adman234/-other/hardware/scorbot-controller/docs/pcb_placement.png

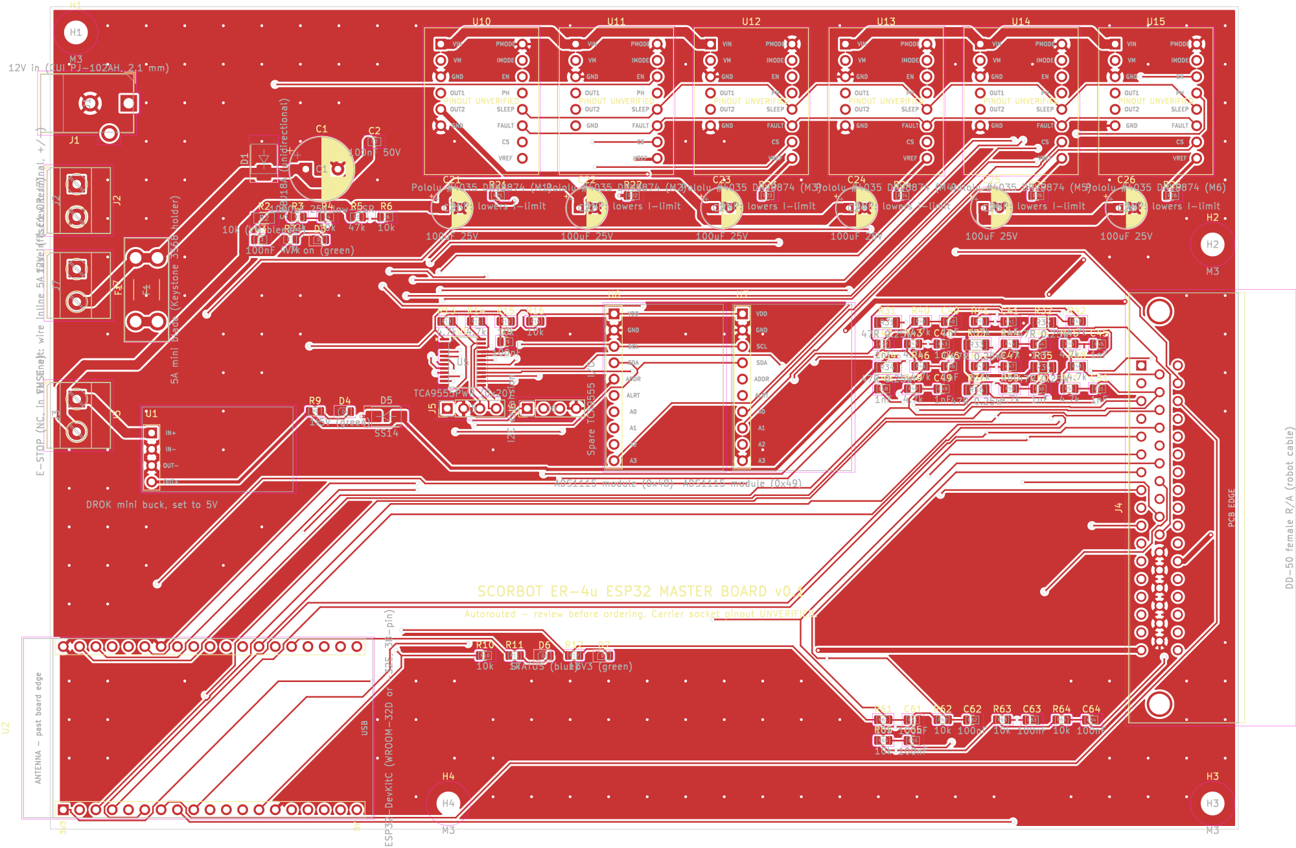
hardware/scorbot-controller/docs/pcb_placement.png
