adman234/-other/hardware/scorbot-controller/docs/schematic.pdf

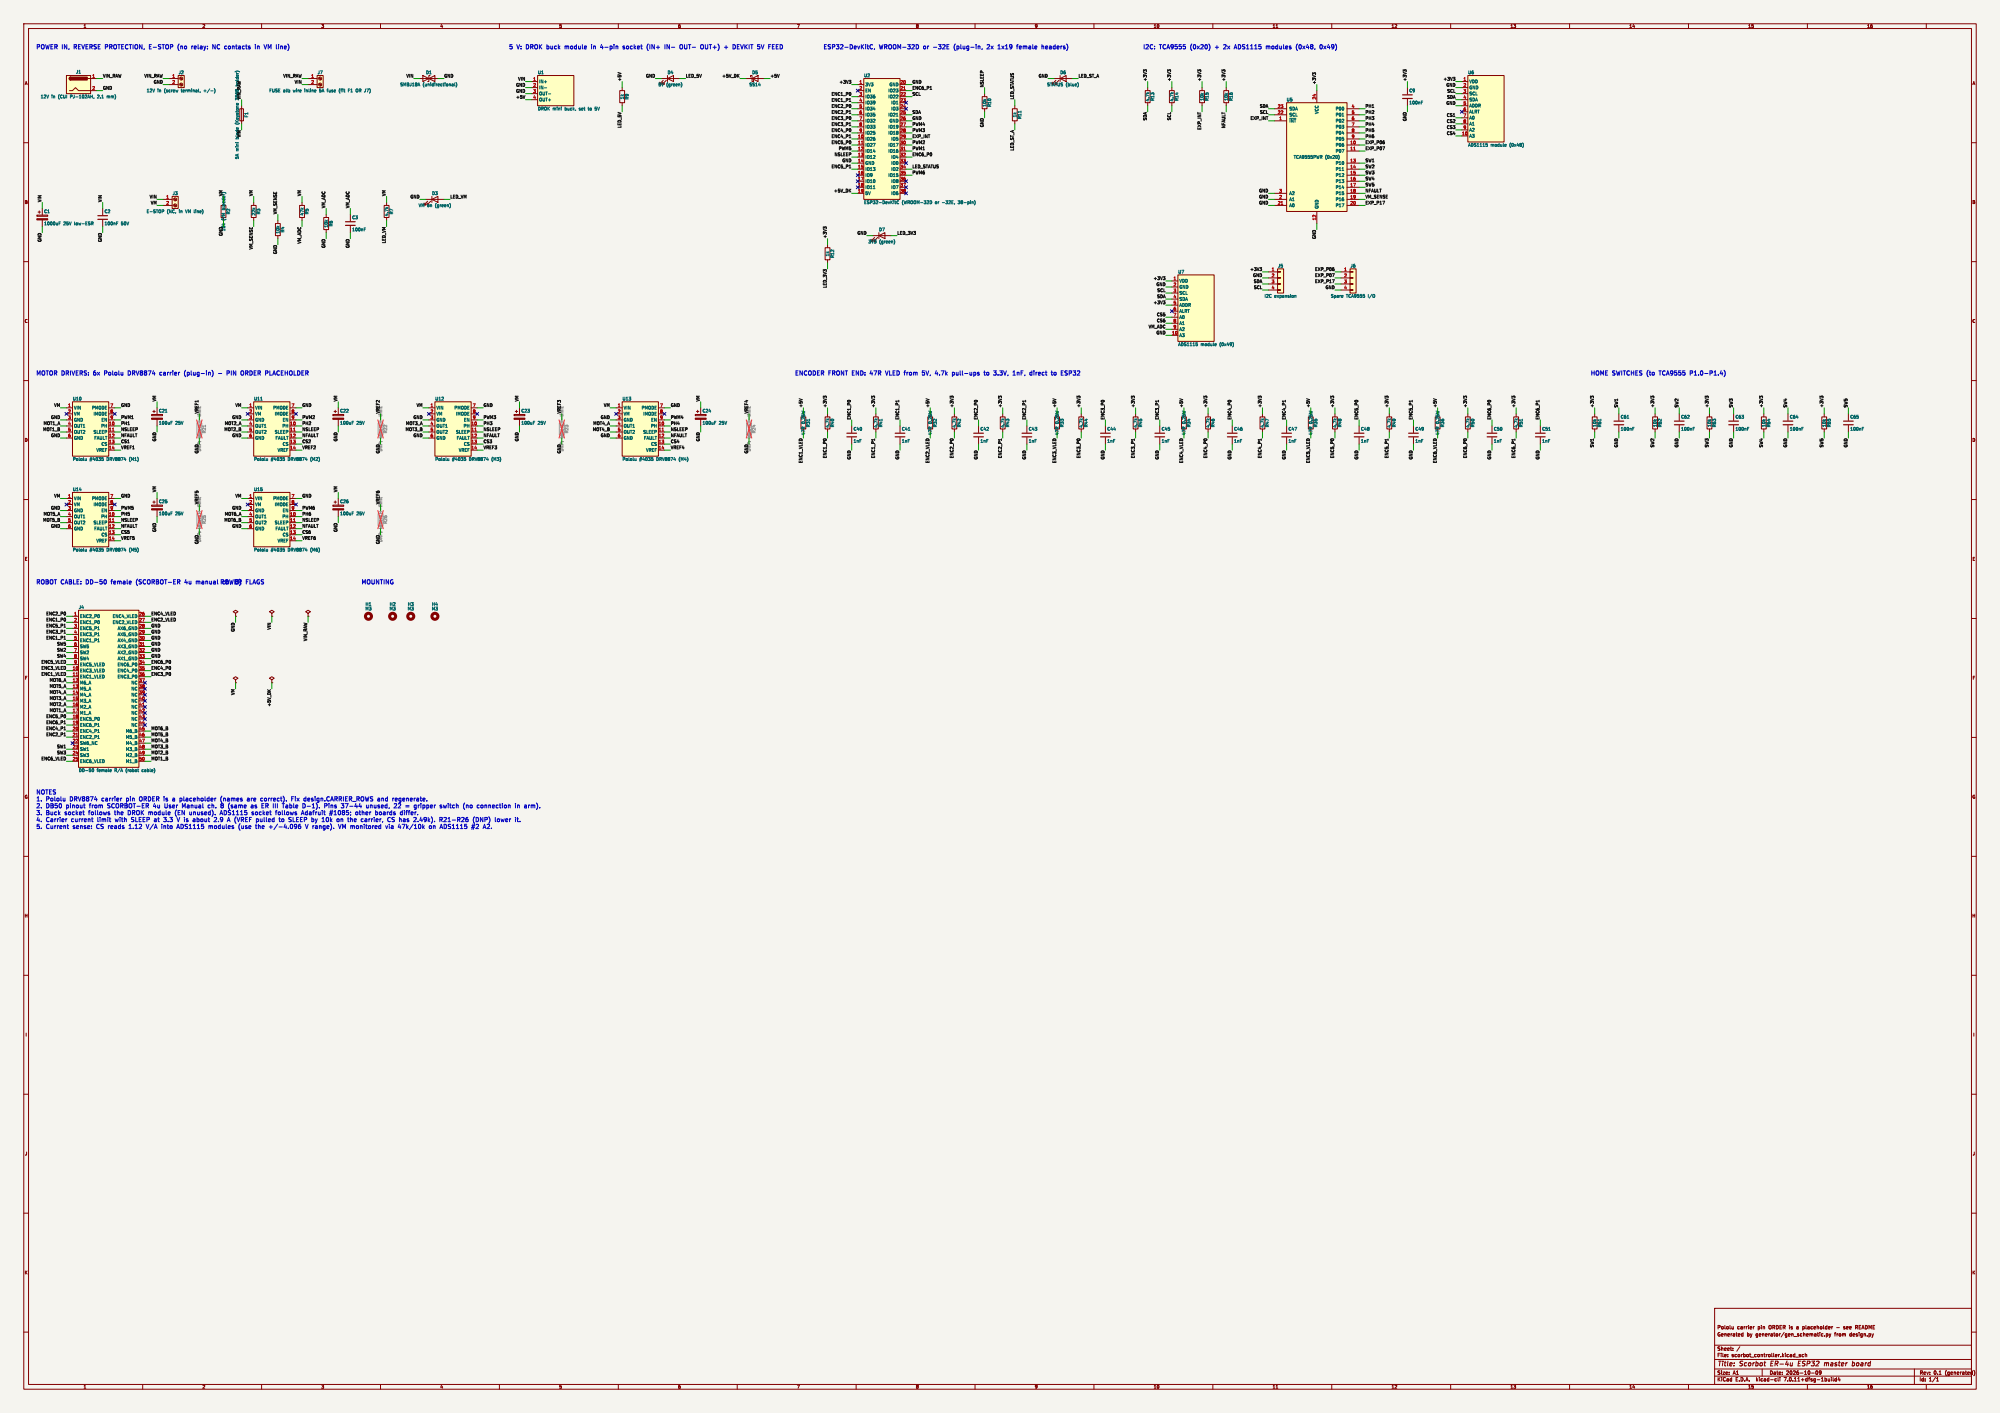
[picture p3: page 1]

J7 FUSE alt: wire inline 5A fuse (fit F1 OR J7) C2
VIN GND
GND

IN- 2 OUT- 3 OUT+ 4 U1 DROK mini buck, set to 5V
