adman234/-other/hardware/scorbot-controller/scorbot_controller.kicad_pcb

## KiCad design hardware/scorbot-controller/scorbot_controller.kicad_pcb (2026-10-11)

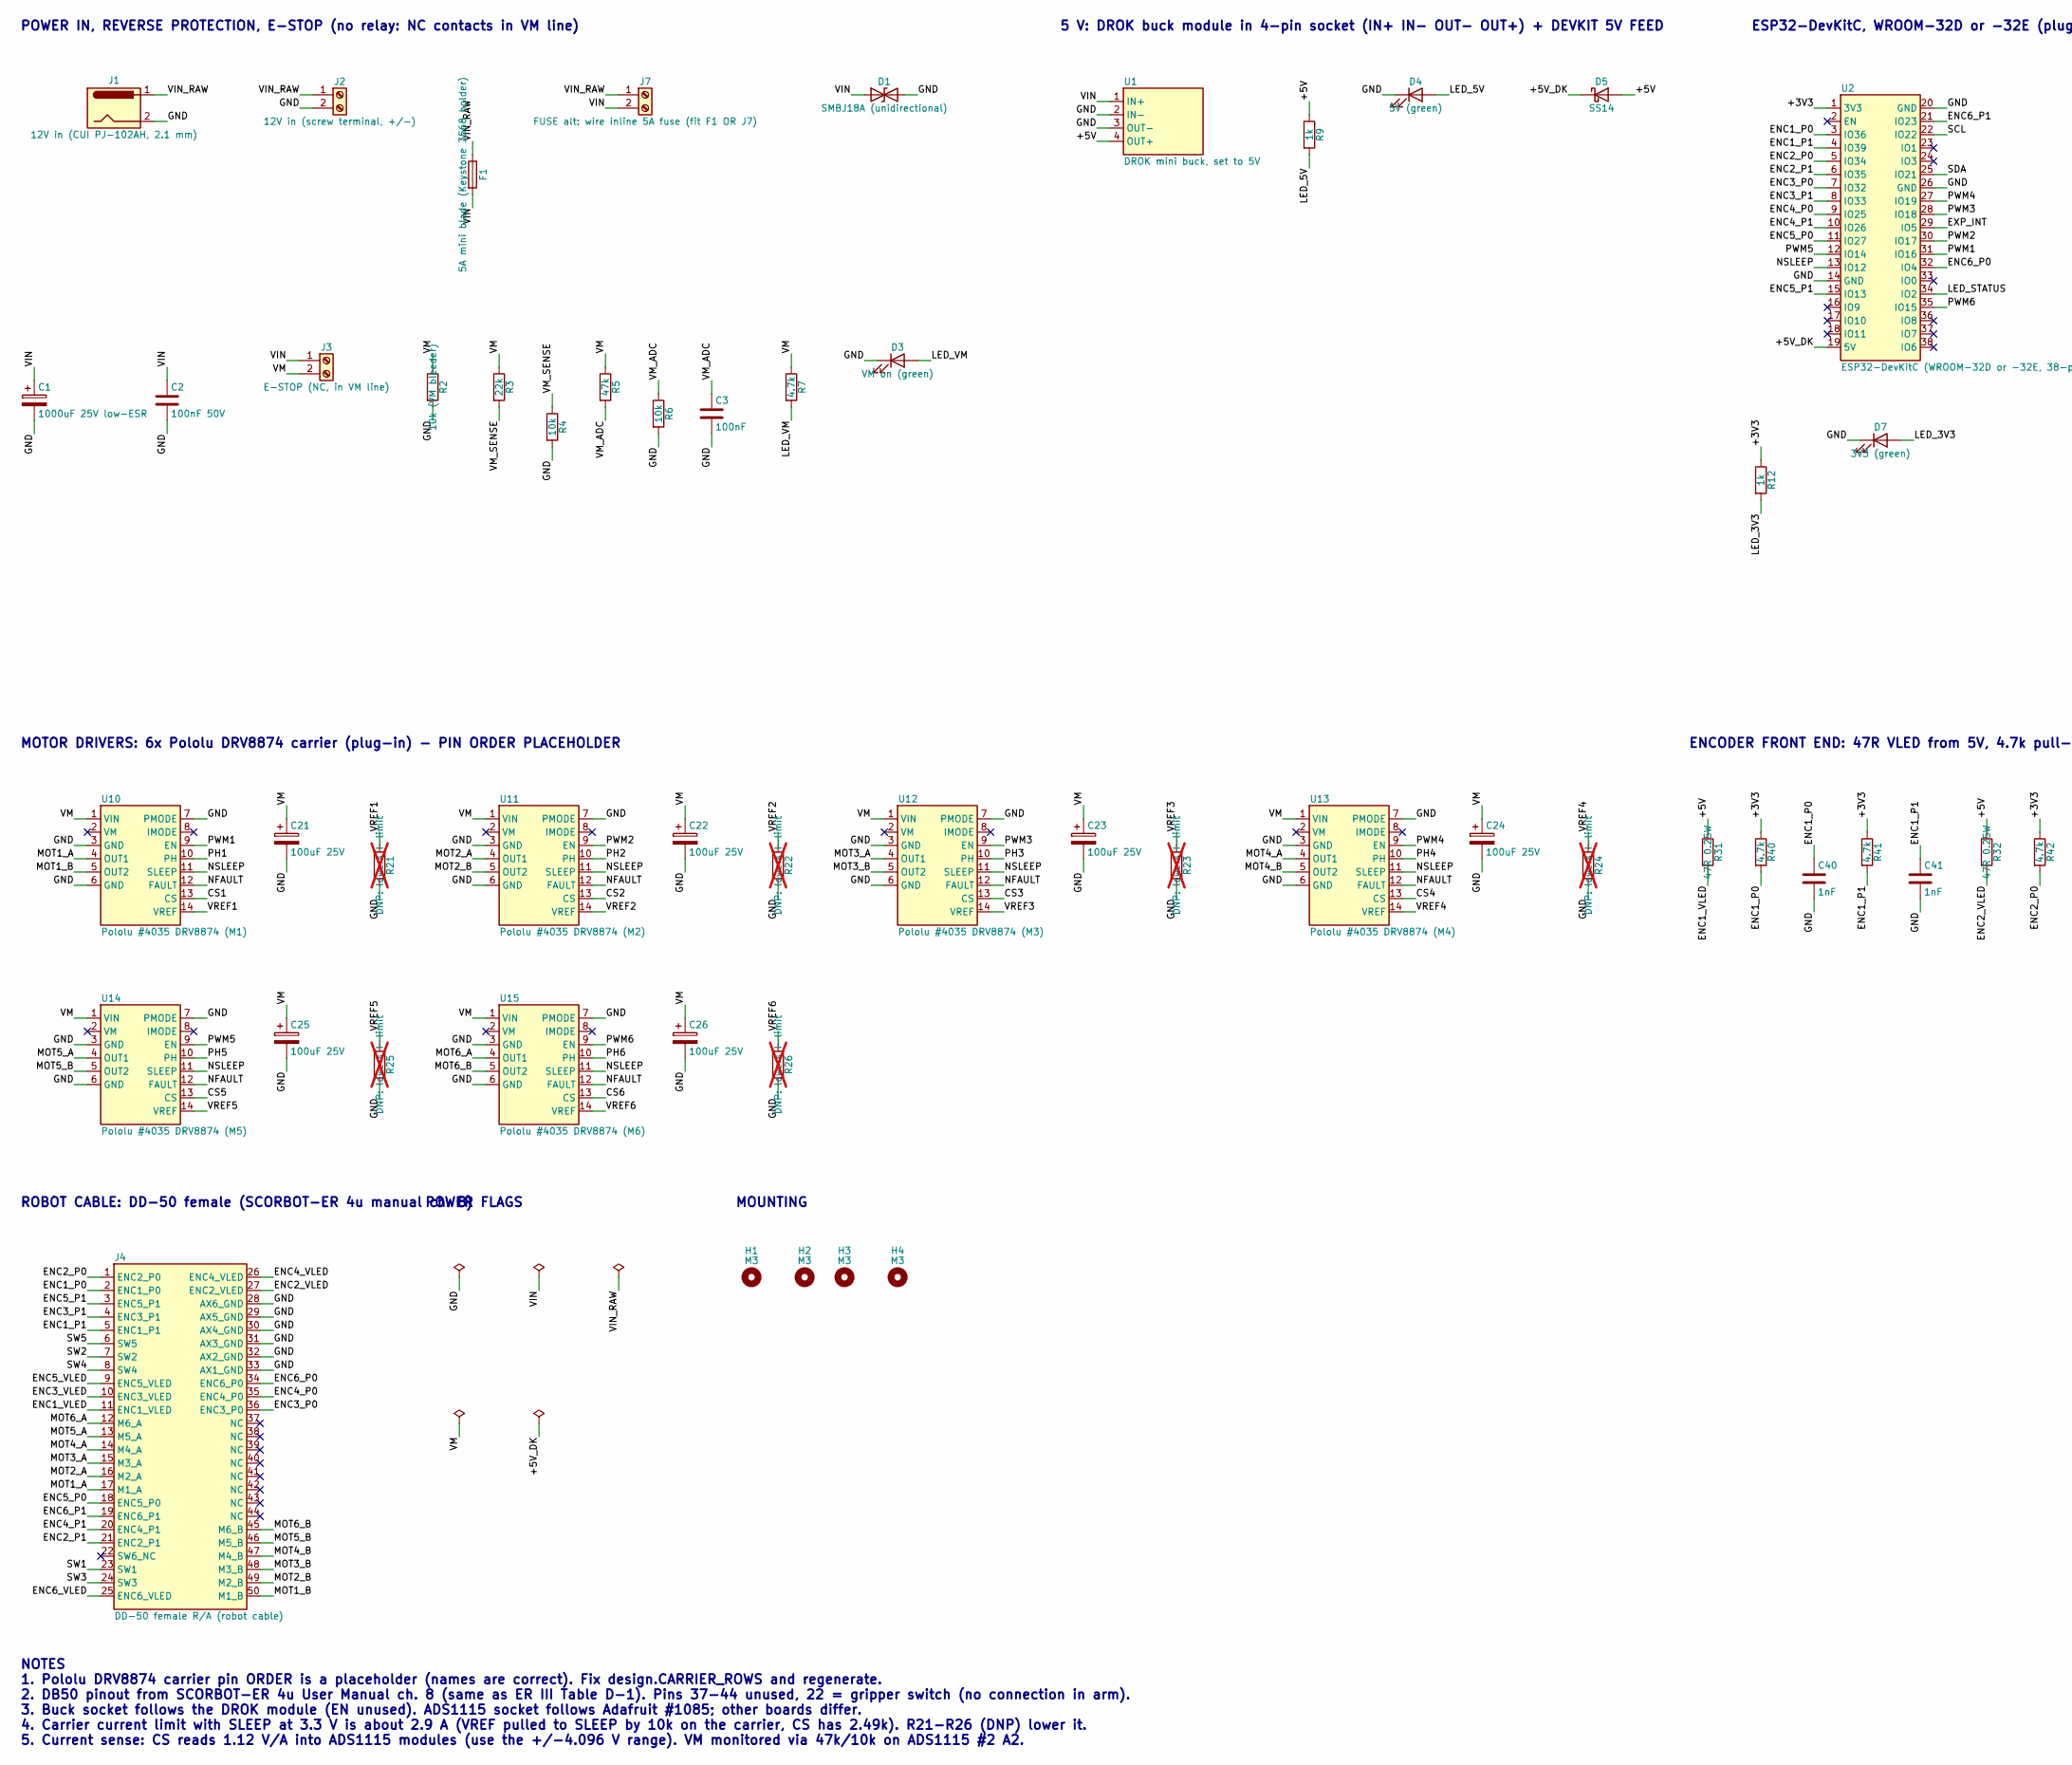
[picture p4: schematic scorbot_controller.kicad_sch, Scorbot ER-4u ESP32 master board, part in row 1, column 1]

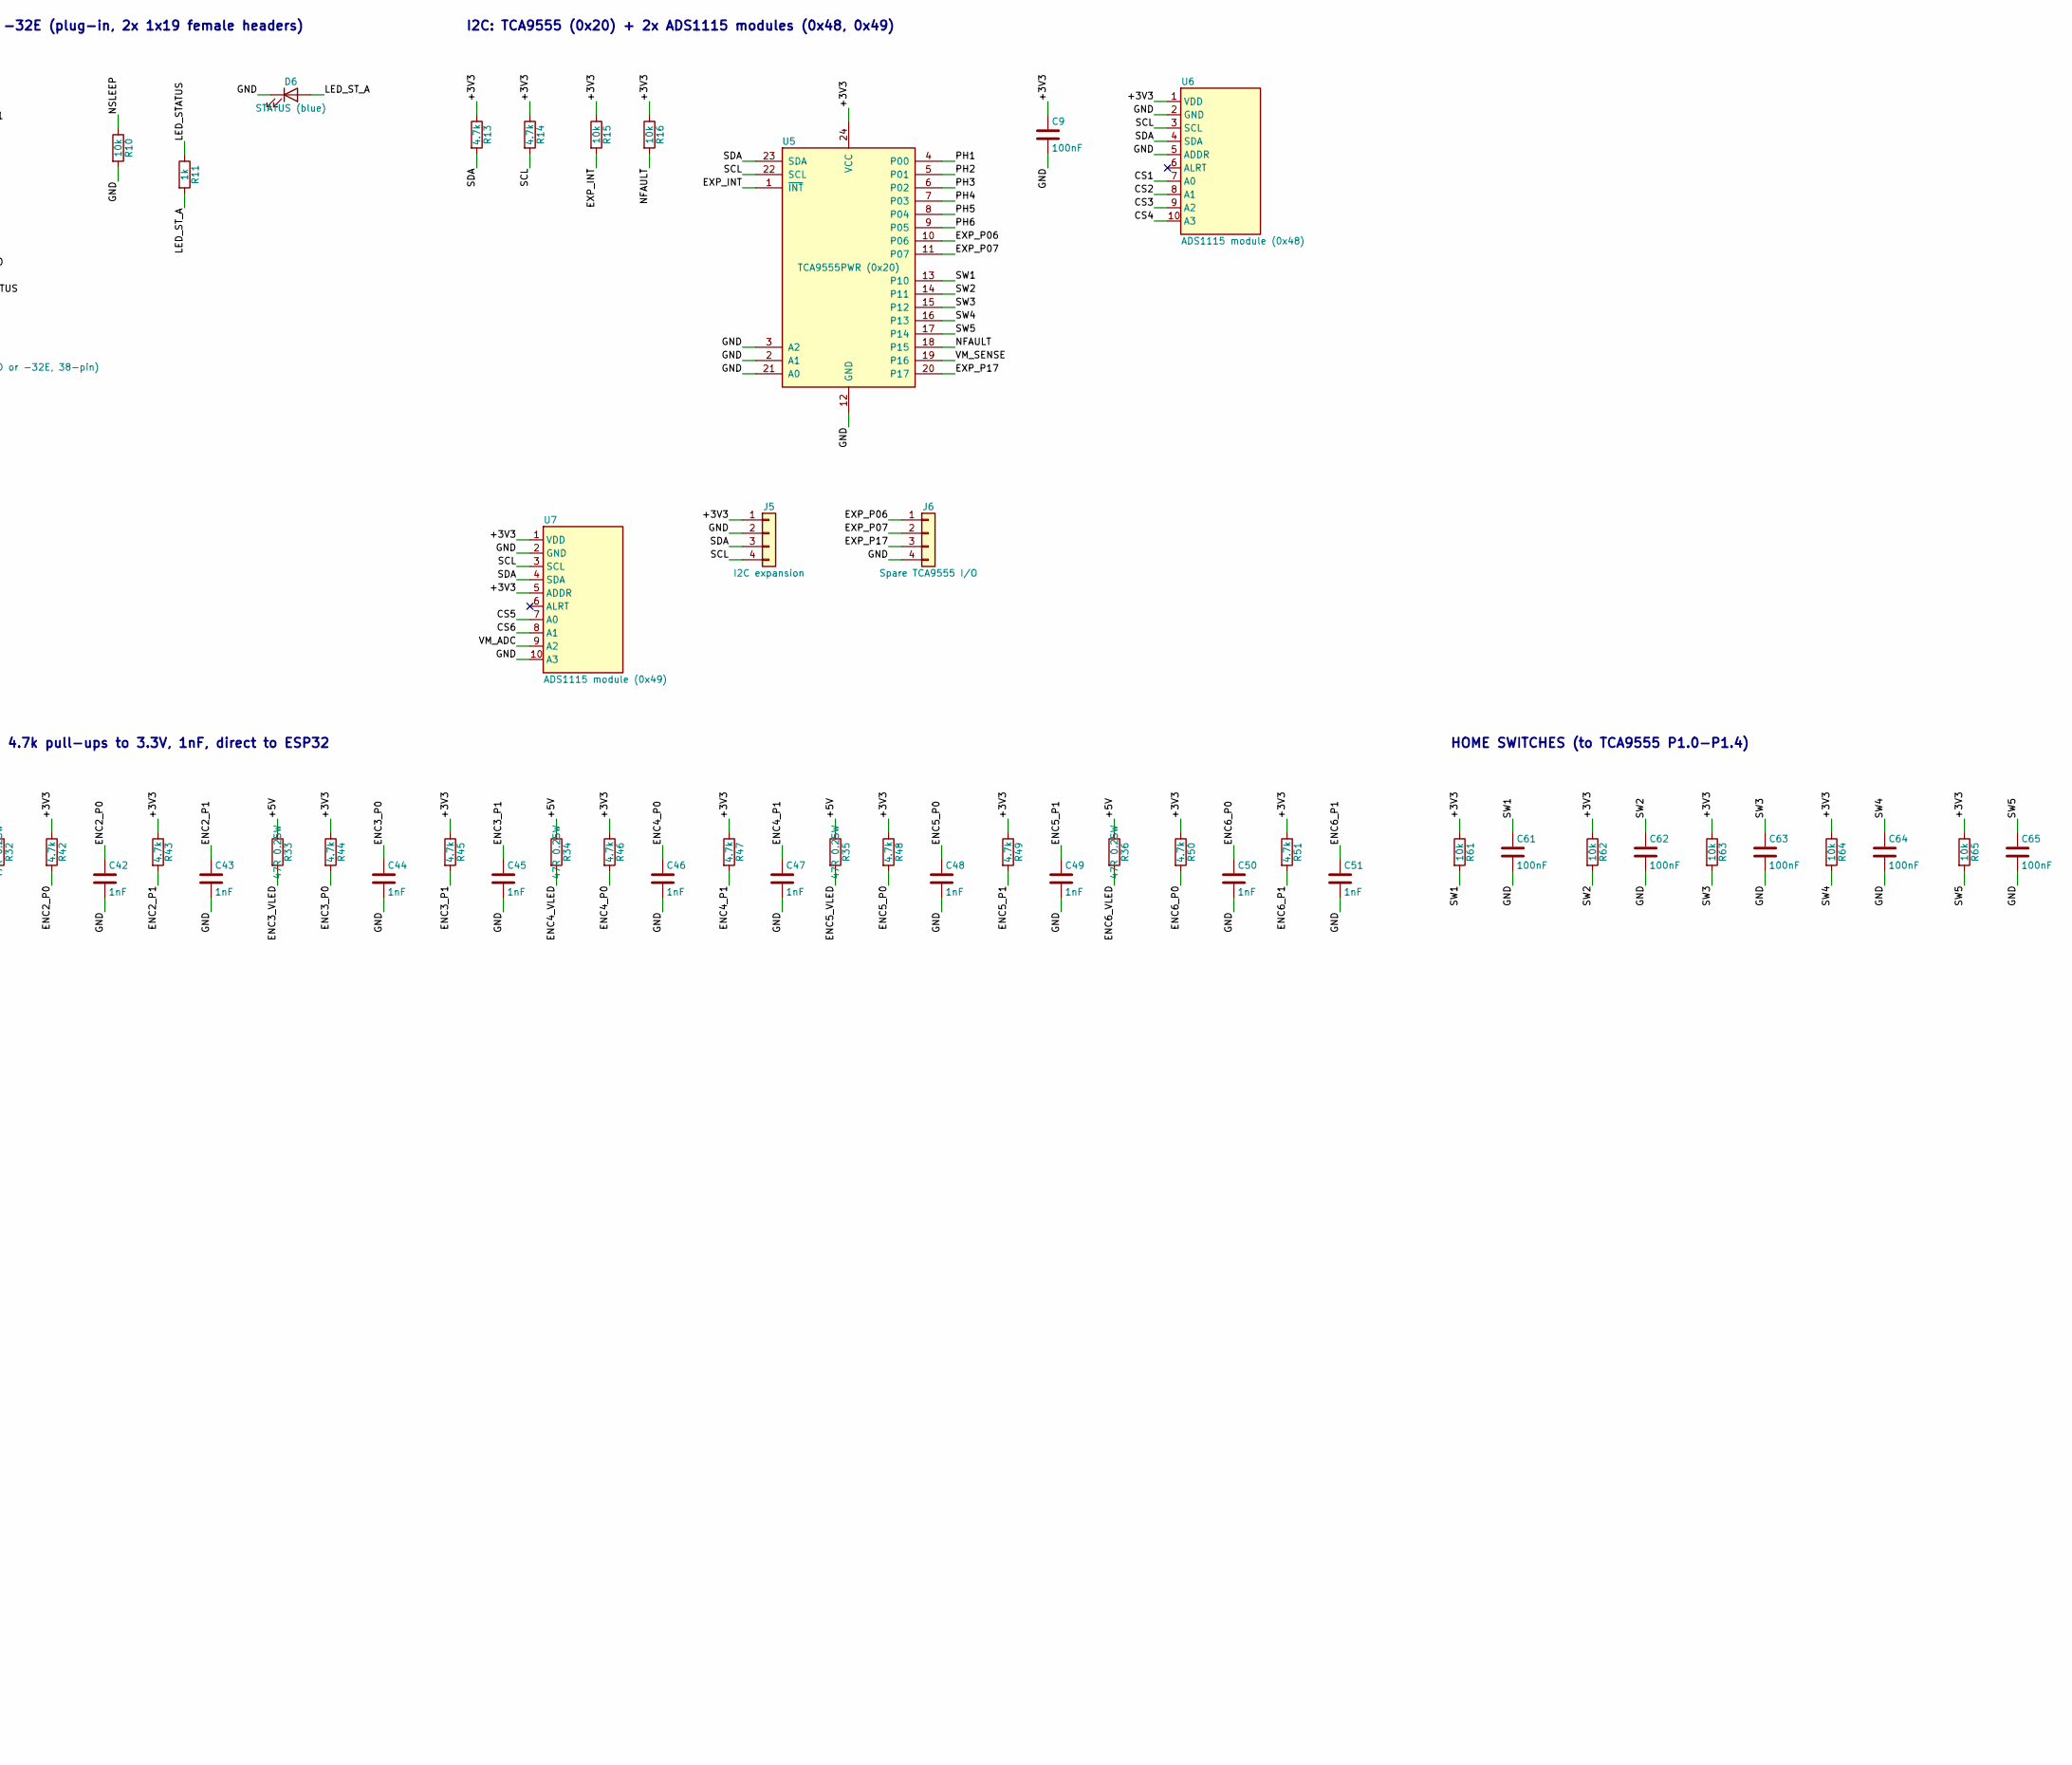
[picture p5: schematic scorbot_controller.kicad_sch, Scorbot ER-4u ESP32 master board, part in row 1, column 2]

Parts:
C1: 1000uF 25V low-ESR; CP_Radial_D10.0mm_P5.00mm
C2: 100nF 50V; C_0805_2012Metric
C3, C9, C61, C62, C63, C64, C65: 100nF; C_0805_2012Metric
C21, C22, C23, C24, C25, C26: 100uF 25V; CP_Radial_D6.3mm_P2.50mm
C40, C41, C42, C43, C44, C45, C46, C47, C48, C49, C50, C51: 1nF; C_0805_2012Metric
D1: SMBJ18A (unidirectional); D_SMB
D3: VM on (green); LED_0805_2012Metric
D4: 5V (green); LED_0805_2012Metric
D5: SS14; D_SMA
D6: STATUS (blue); LED_0805_2012Metric
D7: 3V3 (green); LED_0805_2012Metric
F1: 5A mini blade (Keystone 3568 holder); Fuseholder_Blade_Mini_Keystone_3568
H1, H2, H3, H4: M3; MountingHole_3.2mm_M3
J1: 12V in (CUI PJ-102AH, 2.1 mm); BarrelJack_CUI_PJ-102AH_Horizontal
J2: 12V in (screw terminal, +/-); TerminalBlock_Phoenix_MKDS-1,5-2-5.08_1x02_P5.08mm_Horizont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
J3: E-STOP (NC, in VM line); TerminalBlock_Phoenix_MKDS-1,5-2-5.08_1x02_P5.08mm_Horizont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
J4: DD-50 female R/A (robot cable); DD50_Female_Horizontal_P2.77x2.84mm
J5: I2C expansion; PinHeader_1x04_P2.54mm_Vertical
J6: Spare TCA9555 I/O; PinHeader_1x04_P2.54mm_Vertical
J7: FUSE alt: wire inline 5A fuse (fit F1 OR J7); TerminalBlock_Phoenix_MKDS-1,5-2-5.08_1x02_P5.08mm_Horizont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
R2: 10k (VM bleeder); R_1206_3216Metric
R3: 22k; R_0805_2012Metric
R4, R6, R10, R15, R16, R61, R62, R63, R64, R65: 10k; R_0805_2012Metric
R5: 47k; R_0805_2012Metric
R7, R13, R14, R40, R41, R42, R43, R44, R45, R46, R47, R48, R49, R50, R51: 4.7k; R_0805_2012Metric
R9, R11, R12: 1k; R_0805_2012Metric
R21, R22, R23, R24, R25, R26: DNP: lowers I-limit; R_0805_2012Metric; not fitted
R31, R32, R33, R34, R35, R36: 47R 0.25W; R_1206_3216Metric
U1: DROK mini buck, set to 5V; Buck_Module_4pin_Socket
U2: ESP32-DevKitC (WROOM-32D or -32E, 38-pin); ESP32_DevKitC_V4_Socket
U5: TCA9555PWR (0x20); TSSOP-24_4.4x7.8mm_P0.65mm
U6: ADS1115 module (0x48); ADS1115_Module_Socket
U7: ADS1115 module (0x49); ADS1115_Module_Socket
U10: Pololu #4035 DRV8874 (M1); Pololu_DRV8874_Carrier_Socket
U11: Pololu #4035 DRV8874 (M2); Pololu_DRV8874_Carrier_Socket
U12: Pololu #4035 DRV8874 (M3); Pololu_DRV8874_Carrier_Socket
U13: Pololu #4035 DRV8874 (M4); Pololu_DRV8874_Carrier_Socket
U14: Pololu #4035 DRV8874 (M5); Pololu_DRV8874_Carrier_Socket
U15: Pololu #4035 DRV8874 (M6); Pololu_DRV8874_Carrier_Socket

Connections:
+3V3: C9.1, J5.1, R12.1, R13.1, R14.1, R15.1, R16.1, R40.1, R41.1, R42.1, R43.1, R44.1, R45.1, R46.1, R47.1, R48.1, R49.1, R50.1, R51.1, R61.1, R62.1, R63.1, R64.1, R65.1, U2.1 (3V3), U5.24 (VCC), U6.1 (VDD), U7.1 (VDD), U7.5 (ADDR)
+5V: D5.2 (A), R9.1, R31.1, R32.1, R33.1, R34.1, R35.1, R36.1, U1.4 (OUT+)
+5V_DK: D5.1 (K), U2.19 (5V)
CS1: U6.7 (A0), U10.13 (CS)
CS2: U6.8 (A1), U11.13 (CS)
CS3: U6.9 (A2), U12.13 (CS)
CS4: U6.10 (A3), U13.13 (CS)
CS5: U7.7 (A0), U14.13 (CS)
CS6: U7.8 (A1), U15.13 (CS)
ENC1_P0: C40.1, J4.2 (ENC1_P0), R40.2, U2.3 (IO36)
ENC1_P1: C41.1, J4.5 (ENC1_P1), R41.2, U2.4 (IO39)
ENC1_VLED: J4.11 (ENC1_VLED), R31.2
ENC2_P0: C42.1, J4.1 (ENC2_P0), R42.2, U2.5 (IO34)
ENC2_P1: C43.1, J4.21 (ENC2_P1), R43.2, U2.6 (IO35)
ENC2_VLED: J4.27 (ENC2_VLED), R32.2
ENC3_P0: C44.1, J4.36 (ENC3_P0), R44.2, U2.7 (IO32)
ENC3_P1: C45.1, J4.4 (ENC3_P1), R45.2, U2.8 (IO33)
ENC3_VLED: J4.10 (ENC3_VLED), R33.2
ENC4_P0: C46.1, J4.35 (ENC4_P0), R46.2, U2.9 (IO25)
ENC4_P1: C47.1, J4.20 (ENC4_P1), R47.2, U2.10 (IO26)
ENC4_VLED: J4.26 (ENC4_VLED), R34.2
ENC5_P0: C48.1, J4.18 (ENC5_P0), R48.2, U2.11 (IO27)
ENC5_P1: C49.1, J4.3 (ENC5_P1), R49.2, U2.15 (IO13)
ENC5_VLED: J4.9 (ENC5_VLED), R35.2
ENC6_P0: C50.1, J4.34 (ENC6_P0), R50.2, U2.32 (IO4)
ENC6_P1: C51.1, J4.19 (ENC6_P1), R51.2, U2.21 (IO23)
ENC6_VLED: J4.25 (ENC6_VLED), R36.2
EXP_INT: R15.2, U2.29 (IO5), U5.1 (~INT)
EXP_P06: J6.1, U5.10 (P06)
EXP_P07: J6.2, U5.11 (P07)
EXP_P17: J6.3, U5.20 (P17)
GND: C1.2, C2.2, C3.2, C9.2, C21.2, C22.2, C23.2, C24.2, C25.2, C26.2, C40.2, C41.2, C42.2, C43.2, C44.2, C45.2, C46.2, C47.2, C48.2, C49.2, C50.2, C51.2, C61.2, C62.2, C63.2, C64.2, C65.2, D1.2 (A2), D3.1 (K), D4.1 (K), D6.1 (K), D7.1 (K), J1.2, J2.2, J4.28 (AX6_GND), J4.29 (AX5_GND), J4.30 (AX4_GND), J4.31 (AX3_GND), J4.32 (AX2_GND), J4.33 (AX1_GND), J5.2, J6.4, R2.2, R4.2, R6.2, R10.2, R21.2, R22.2, R23.2, R24.2, R25.2, R26.2, U1.2 (IN-), U1.3 (OUT-), U2.14 (GND), U2.20 (GND), U2.26 (GND), U5.2 (A1), U5.3 (A2), U5.12 (GND), U5.21 (A0), U6.2 (GND), U6.5 (ADDR), U7.2 (GND), U7.10 (A3), U10.3 (GND), U10.6 (GND), U10.7 (PMODE), U11.3 (GND), U11.6 (GND), U11.7 (PMODE), U12.3 (GND), U12.6 (GND), U12.7 (PMODE), U13.3 (GND), U13.6 (GND), U13.7 (PMODE), U14.3 (GND), U14.6 (GND), U14.7 (PMODE), U15.3 (GND), U15.6 (GND), U15.7 (PMODE)
LED_3V3: D7.2 (A), R12.2
LED_5V: D4.2 (A), R9.2
LED_STATUS: R11.1, U2.34 (IO2)
LED_ST_A: D6.2 (A), R11.2
LED_VM: D3.2 (A), R7.2
MOT1_A: J4.17 (M1_A), U10.4 (OUT1)
MOT1_B: J4.50 (M1_B), U10.5 (OUT2)
MOT2_A: J4.16 (M2_A), U11.4 (OUT1)
MOT2_B: J4.49 (M2_B), U11.5 (OUT2)
MOT3_A: J4.15 (M3_A), U12.4 (OUT1)
MOT3_B: J4.48 (M3_B), U12.5 (OUT2)
MOT4_A: J4.14 (M4_A), U13.4 (OUT1)
MOT4_B: J4.47 (M4_B), U13.5 (OUT2)
MOT5_A: J4.13 (M5_A), U14.4 (OUT1)
MOT5_B: J4.46 (M5_B), U14.5 (OUT2)
MOT6_A: J4.12 (M6_A), U15.4 (OUT1)
MOT6_B: J4.45 (M6_B), U15.5 (OUT2)
NFAULT: R16.2, U5.18 (P15), U10.12 (FAULT), U11.12 (FAULT), U12.12 (FAULT), U13.12 (FAULT), U14.12 (FAULT), U15.12 (FAULT)
NSLEEP: R10.1, U2.13 (IO12), U10.11 (SLEEP), U11.11 (SLEEP), U12.11 (SLEEP), U13.11 (SLEEP), U14.11 (SLEEP), U15.11 (SLEEP)
PH1: U5.4 (P00), U10.10 (PH)
PH2: U5.5 (P01), U11.10 (PH)
PH3: U5.6 (P02), U12.10 (PH)
PH4: U5.7 (P03), U13.10 (PH)
PH5: U5.8 (P04), U14.10 (PH)
PH6: U5.9 (P05), U15.10 (PH)
PWM1: U2.31 (IO16), U10.9 (EN)
PWM2: U2.30 (IO17), U11.9 (EN)
PWM3: U2.28 (IO18), U12.9 (EN)
PWM4: U2.27 (IO19), U13.9 (EN)
PWM5: U2.12 (IO14), U14.9 (EN)
PWM6: U2.35 (IO15), U15.9 (EN)
SCL: J5.4, R14.2, U2.22 (IO22), U5.22 (SCL), U6.3 (SCL), U7.3 (SCL)
SDA: J5.3, R13.2, U2.25 (IO21), U5.23 (SDA), U6.4 (SDA), U7.4 (SDA)
SW1: C61.1, J4.23 (SW1), R61.2, U5.13 (P10)
SW2: C62.1, J4.7 (SW2), R62.2, U5.14 (P11)
SW3: C63.1, J4.24 (SW3), R63.2, U5.15 (P12)
SW4: C64.1, J4.8 (SW4), R64.2, U5.16 (P13)
SW5: C65.1, J4.6 (SW5), R65.2, U5.17 (P14)
VIN: C1.1, C2.1, D1.1 (A1), F1.2, J3.1, J7.2, U1.1 (IN+)
VIN_RAW: F1.1, J1.1, J2.1, J7.1
VM: C21.1, C22.1, C23.1, C24.1, C25.1, C26.1, J3.2, R2.1, R3.1, R5.1, R7.1, U10.1 (VIN), U11.1 (VIN), U12.1 (VIN), U13.1 (VIN), U14.1 (VIN), U15.1 (VIN)
VM_ADC: C3.1, R5.2, R6.1, U7.9 (A2)
VM_SENSE: R3.2, R4.1, U5.19 (P16)
VREF1: R21.1, U10.14 (VREF)
VREF2: R22.1, U11.14 (VREF)
VREF3: R23.1, U12.14 (VREF)
VREF4: R24.1, U13.14 (VREF)
VREF5: R25.1, U14.14 (VREF)
VREF6: R26.1, U15.14 (VREF)

Notes on the sheet:
POWER IN, REVERSE PROTECTION, E-STOP (no relay: NC contacts in VM line)
5 V: DROK buck module in 4-pin socket (IN+ IN- OUT- OUT+) + DEVKIT 5V FEED
ESP32-DevKitC, WROOM-32D or -32E (plug-in, 2x 1x19 female headers)
I2C: TCA9555 (0x20) + 2x ADS1115 modules (0x48, 0x49)
MOTOR DRIVERS: 6x Pololu DRV8874 carrier (plug-in) - PIN ORDER PLACEHOLDER
ENCODER FRONT END: 47R VLED from 5V, 4.7k pull-ups to 3.3V, 1nF, direct to ESP32
HOME SWITCHES (to TCA9555 P1.0-P1.4)
ROBOT CABLE: DD-50 female (SCORBOT-ER 4u manual ch. 8)
POWER FLAGS
MOUNTING
NOTES 1. Pololu DRV8874 carrier pin ORDER is a placeholder (names are correct). Fix design.CARRIER_ROWS and regenerate. 2. DB50 pinout from SCORBOT-ER 4u User Manual ch. 8 (same as ER III Table D-1). Pins 37-44 unused, 22 = gripper switch (no connection in arm). 3. Buck socket follows the DROK modu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

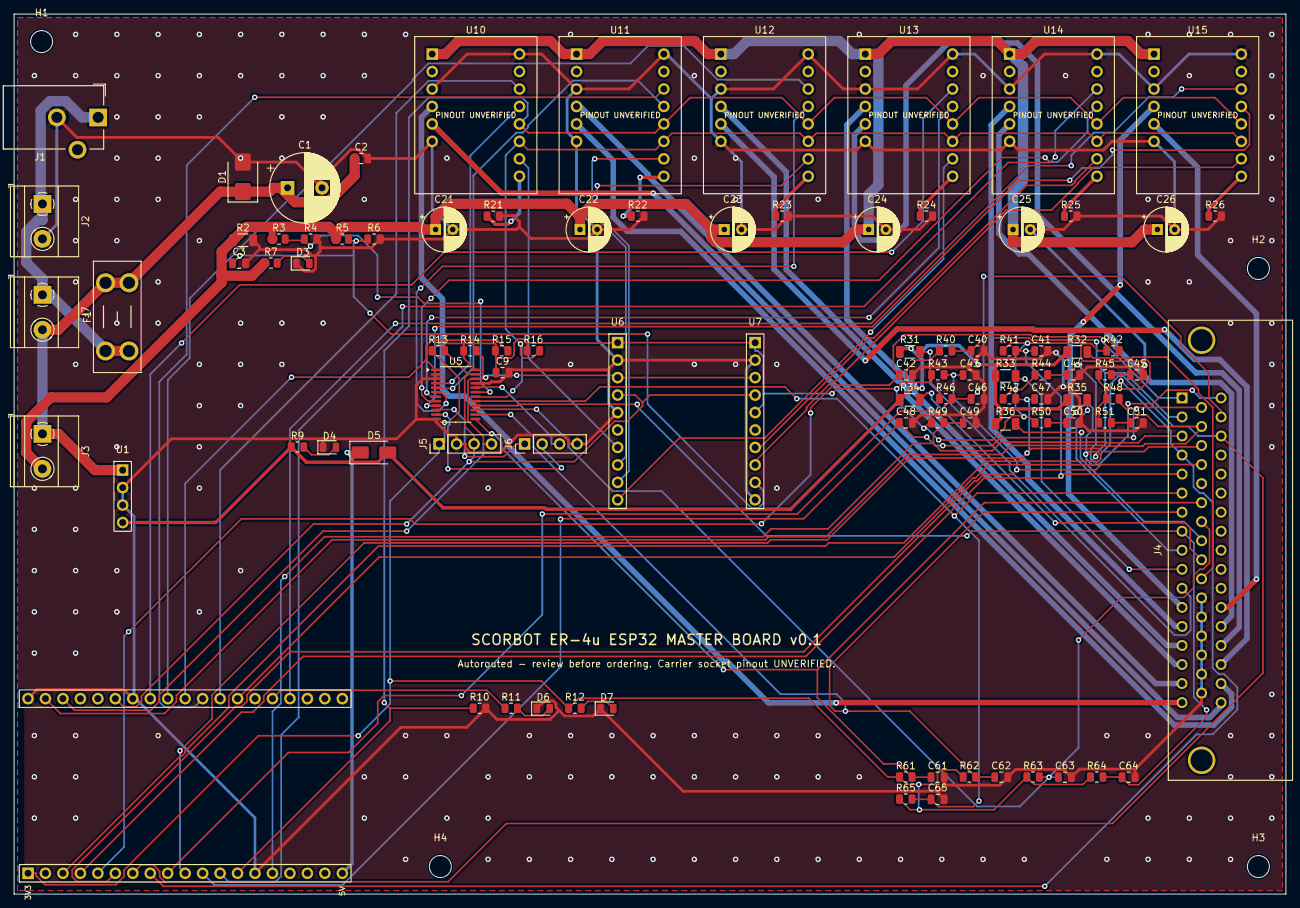
[picture p6: board scorbot_controller.kicad_pcb from above]

Board: 2 copper layers, 185.0 x 128.0 mm, 99 parts (0 on the bottom side), 81 nets.
