adman234/-other/(commit log)

2026-10-07 Add VRAM-reducing handler patch and options to Unraid template
    Mounts a patched handler.py that sets ONNX Runtime CUDA provider options
    (kSameAsRequested arena growth, heuristic cuDNN search, optional
    gpu_mem_limit) to cut GPU memory overhead.
    Claude-Session: https://claude.ai/code/session_01N6ukEU8soEx5XCEeYdX9KW
2026-10-09 Add generated KiCad project for Scorbot ER-4u ESP32 master board
    Schematic, placed (unrouted) PCB, custom DevKit/DRV8874-carrier/DD-50
    footprints and a Python generator with design.py as the single source of
    truth. generate.sh rebuilds everything and checks the KiCad netlist against
    the design and runs DRC. DB50 pinout from the ER-4u manual ch. 8.
    Claude-Session: https://claude.ai/code/session_01EVE6PZ95cMufMkAr9pDFuN
    [bom.csv, scorbot_controller.kicad_pcb, scorbot_controller.kicad_sch]
2026-10-10 Swap buck, ADC and encoder buffers for plug-in modules
    Replace the AP63205 buck with a Pololu D24V22F5 module, the ADS7828 with
    two ADS1115 breakout modules, drop the 74LVC14 encoder buffers (4.7k
    pull-ups to 3.3V straight to the ESP32) and the reverse-polarity FET.
    TCA9555 stays as the only SMD IC. Module pin orders are placeholders.
    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
    [bom.csv, scorbot_controller.kicad_pcb, scorbot_controller.kicad_sch]
2026-10-10 Update schematic notes for the module-based design
    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
    [scorbot_controller.kicad_pcb, scorbot_controller.kicad_sch]
2026-10-10 Board rev: screw terminals for fuse and E-stop, 4-pin DROK buck socket
    Fuse holder replaced by a screw terminal (wire an inline fuse across it),
    E-stop plug replaced by a screw terminal, buck module socket now IN+, IN-,
    OUT-, OUT+ to match the DROK mini buck. Barrel jack footprint matched to
    CUI PJ-102AH. ADS1115 socket follows Adafruit #1085. DevKit relabelled for
    WROOM-32D or -32E (same pins).
    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
2026-10-10 Add ESP-IDF firmware, web UI with test/calibration/3D view, and simulator tests
    - Robot core: 1 kHz PID with trapezoid moves, differential wrist, homing,
    travel calibration, motor/switch/encoder self-tests, safety latches
    - ESP32 HAL: PCNT encoders, LEDC PWM, TCA9555 + 2x ADS1115 over I2C
    - WiFi STA with AP/captive-portal fallback, mDNS, HTTP + WebSocket API
    - Single-file web UI: 3D arm view, jog, test, calibrate and settings tabs,
    demo mode with a mock arm
    - Host tests: core unit tests on a physics sim, sim bridge, Playwright UI test
    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
2026-10-11 Board: screw-terminal power input beside the barrel jack, optional on-board blade fuse holder
    - J2 is now a plain 5.08 mm screw terminal (alternative to barrel jack J1)
    - F1 Keystone 3568 mini blade holder in parallel with the J7 fuse terminal; fit one
    - Net classes for Power/Motor/Supply; gen_route.py autoroutes with Freerouting
    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
2026-10-11 Keep net classes in the project file after board saves; ignore router logs
    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
2026-10-11 gen_route: import Freerouting sessions directly, keep off the board edge, add top GND pour
    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
2026-10-11 Autoroute the master board with Freerouting
    - gen_route.py: DSN export with per-class widths (Power 1.5 mm, Motor 0.8 mm,
    Supply 0.5 mm, GND 0.4 mm + pours), headless Freerouting, direct session
    import, GND pours on both layers with stitching vias, retry until complete
    - DRC: 0 unconnected, 0 clearance errors
    - Routed F/B previews in docs/
    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
2026-10-11 Add JLCPCB fab outputs (Gerbers, drill, BOM, CPL) and a pre-order checklist
    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
